Stab-Rabbit-coding/open-servo-core-secure/REFERENCES.md

# REFERENCES

Catalogue of every external standard, datasheet, specification and source this
repository relies on. Citations elsewhere in the codebase — in Rust doc
comments, Markdown, schematics and commit messages — refer to entries here by
**REF-ID**.

**Policy.** No reference, citation, standard, section number or constant is
ever fabricated. Where a value cannot be traced to a published document with a
validated URL, it is either omitted or explicitly marked *requires
verification*, and a `TODO.md` item is opened against it.

---

## Secure element

### REF-SE-001 — ECC204 CryptoAuthentication Summary Data Sheet

- **Designation:** Microchip DS40002436C (2023–2025)
- **Title:** *ECC204 CryptoAuthentication™ Summary Data Sheet*
- **URL:** <https://ww1.microchip.com/downloads/aemDocuments/documents/SCBU/ProductDocuments/DataSheets/ECC204-CryptoAuthentication-Summary-Data-Sheet-DS40002436.pdf>
- **Local copy:** `docs/ECC204-CryptoAuthentication-Summary-Data-Sheet-DS40002436.pdf`
- **Sections applied:**
  - *Features* (p. 1) — ECDSA P-256 **sign only**; SHA-256 and HMAC; internal
    TRNG; single ECC private key, one device certificate, one CA signer
    certificate, single symmetric secret key, 64-byte user memory; monotonic
    counter **max 10 000**; unique 72-bit serial; SWI at **100 kbps** and I²C
    at **400 kHz**; JIL "High" attack-potential resistance; FIPS 140-3
    compliance-mode option.
  - *Table 1 / Figure 1* (p. 2) — pin configuration; SWI vs I²C pin functions;
    3-lead contact, 8-pad UDFN, 8-lead SOIC packages.
  - *§1.2 Device Features* — EEPROM contents, interface options, parasitic
    power mode, counter attachment to key.
  - *§1.3 Cryptographic Operation* — private key generated internally, never
    exposed.
  - *§2.1 Cryptographic Standards* — SHA-256 (FIPS 180-4), HMAC (FIPS 198-1),
    ECDSA (ANSI X9.62-2005, FIPS 186-5).
  - *§2.2.2 Random Number Generator* — SP 800-90A/B/C certified TRNG.
  - *§2.2.3 Compliance Mode* — FIPS 140-3 enforcement bit.
  - *§3.1 Absolute Maximum Ratings* — ESD HBM **> 4 kV (I²C)**, **> 7 kV
    (SWI)**, CDM > 2 kV.
  - *§3.2.1* — DC parameters, all I/O interfaces: Theta-JA **91.5°C/W** for
    the 3-lead contact package (soldered-down); sleep current 130 nA typ.
  - *§3.2.2 / §3.2.3* — SWI DC parameters and parasitic-power mode.
  - *§4 / Table 4-1* — Trust&GO / TrustFLEX / TrustCUSTOM provisioning flows;
    ordering codes. **Note 3**: the TrustCUSTOM sample device
    `ECC204-TCSMU`/`ECC204-TCSMS` is stated equivalent to
    `ECC204-MAVDA-T`/`ECC204-SSVDA-T` — **I²C**, not SWI. This table does not
    show a 3-lead-contact or SWI (`CZ`) Trust Platform SKU; it is a
    "representative sample" (Note 1), not exhaustive. This is the open part of
    the `TODO.md` §7.1 blocker — whether a pre-provisioned (TrustFLEX/
    TrustCUSTOM) SWI part exists is still unconfirmed from this datasheet.
  - *§6.1 / Package Drawings — 8-Pad UDFN* (Q4B, Atmel legacy code YNZ,
    Microchip drawing C04-21355-Q4B Rev C): body 2.00×3.00 mm BSC, height
    0.50–0.60 mm, pitch (`e`) 0.50 mm BSC, exposed pad D2 1.40–1.60 mm,
    exposed pad E2 1.20–1.40 mm, terminal width (`b`) 0.18–0.30 mm, terminal
    length (`L`) 0.25–0.45 mm, **terminal-to-exposed-pad (`K`) 0.20 mm min**.
    Used, with the `K` clearance applied against the pulled-in peripheral
    pads rather than the nominal exposed-pad size, for
    `hardware/shared.pretty/ECC204_UDFN-8-1EP_L2.0-W3.0-P0.50-EP0.61x1.3mm.kicad_mod`
    — see that file's description field and `TODO.md` §7.8 for the exact
    derivation; verify against a real part/stencil before fab.
  - *§6.3 / Package Drawings — 3-Lead Contact* (Atmel legacy code RHB,
    Microchip drawing C04-21303 Rev A): body 6.50×2.50 mm BSC, height
    0.45–0.55 mm, pitch 2.00 mm BSC, terminal width (`b`) 1.60–1.80 mm,
    terminal length (`L`) 2.10–2.30 mm. **Superseded** — see "Removed /
    superseded citations" below; this package does not fit
    `osc-sg90-v006`'s routed copper anywhere.
  - *§7 / Product Identification System* — the **plain** (non-Trust-Platform)
    ordering-code grammar has an explicit interface column: package `RB`
    (3-lead contact) / `MA` (UDFN) / `SS` (SOIC) × I/O type `CZ` (SWI) /
    `DA` (I²C). `ECC204-MAVCZ-T` (8-pad UDFN, extended temp, SWI, tape &
    reel) is a **verbatim example** from this section, used as the schematic
    symbol name (`hardware/shared.kicad_sym`,
    `hardware/boards/osc-sg90-v006/osc-sg90-v006.kicad_sch` U7). This is a
    real, orderable **unprovisioned** device — it is not the fleet
    provisioning SKU, which remains open per `TODO.md` §7.1/§7.5.
- **Cited from:** `docs/security-architecture.md` (§0.1–0.5, §2, §3, §5, §6),
  `firmware/lib/drivers/src/se/ecc204.rs`,
  `firmware/lib/osc-security/src/se.rs`, `firmware/lib/osc-security/src/keys.rs`
- **Limitation (important):** this is the **summary** datasheet. It states on
  its cover that the complete document is available only under NDA. It
  contains **no command set, no execution times, no command-packet framing and
  no SWI token timing**. Those gaps are the reason for the compile gate in
  `se/ecc204.rs` (see `TODO.md` §7.4).

### REF-SE-002 — Microchip CryptoAuthLib

- **Title:** *CryptoAuthLib — Library for interacting with the CryptoAuthentication secure elements*
- **URL:** <https://github.com/MicrochipTech/cryptoauthlib>
- **Files applied:**
  - `lib/calib/calib_command.h` — command opcodes (`ATCA_READ` 0x02,
    `ATCA_MAC` 0x08, `ATCA_WRITE` 0x12, `ATCA_DELETE` 0x13, `ATCA_NONCE` 0x16,
    `ATCA_LOCK` 0x17, `ATCA_COUNTER` 0x24, `ATCA_INFO` 0x30, `ATCA_GENKEY`
    0x40, `ATCA_SIGN` 0x41, `ATCA_SHA` 0x47, `ATCA_SELFTEST` 0x77);
    ECC204-specific SHA modes (`SHA_MODE_ECC204_HMAC_START` 0x03,
    `SHA_MODE_ECC204_HMAC_END` 0x02); `COUNTER_MAX_VALUE_CA2` = 10000;
    `ATCA_CA2_CONFIG_SIZE` = 64; `ATCA_CA2_CONFIG_SLOT_SIZE` = 16.
  - `lib/calib/calib_execution.c` — `device_execution_time_ecc204` table:
    `COUNTER` 20 ms, `DELETE` 200 ms, `GENKEY` 500 ms, `INFO` 20 ms, `LOCK`
    80 ms, `NONCE` 20 ms, `READ` 40 ms, `SELFTEST` 600 ms, `SHA` 80 ms,
    `SIGN` 500 ms, `WRITE` 80 ms.
- **Cited from:** `firmware/lib/drivers/src/se/ecc204.rs`,
  `docs/security-architecture.md` §0.1
- **Note:** used as a **documentary source for interface constants only**. No
  CryptoAuthLib code is copied into this repository; the drivers here are
  independent Rust implementations. CryptoAuthLib is distributed under
  Microchip's own licence — consult it before vendoring any of its code.
- **Cross-check:** the 10 000 counter ceiling appears independently in
  REF-SE-001 §Features and in `COUNTER_MAX_VALUE_CA2`, which is why it is
  treated as reliable.

### REF-SE-003 — CryptoAuthLib SWI-over-UART HAL

- **Title:** *cryptoauthlib — `lib/hal/hal_swi_uart.c`*
- **URL:** <https://github.com/MicrochipTech/cryptoauthlib/blob/main/lib/hal/hal_swi_uart.c>
- **Applied:** the SWI-over-UART encoding — **230 400 baud** for data
  (115 200 during the wake sequence), **one UART character per SWI data bit**
  (`0x7F` = logic 1, `0x7D` = logic 0), **LSB first**, receive tolerance
  `(c ^ 0x7F) < 2`.
- **Cited from:** `firmware/lib/drivers/src/se/swi.rs`,
  `docs/security-architecture.md` §0.1, §0.3
- **Note:** independent Rust implementation of the documented encoding; no code
  copied.

### REF-SE-004 — Security Exchange Process for TrustFLEX and TrustCUSTOM Provisioning

- **Designation:** Microchip DS50004144
- **Title:** *Security Exchange Process for TrustFLEX and TrustCUSTOM Provisioning*
- **Local copy:** `docs/Security-Exchange-Process-for-TrustFLEX-and-TrustCUSTOM-Provisioning-DS50004144.pdf`
- **Applied:** provisioning flow and Secure Exchange Package handling.
- **Cited from:** `docs/security-architecture.md` §5.1
- **Status:** *requires verification* — specific section numbers have not yet
  been extracted and applied. `TODO.md` §7.5.

### REF-SE-005 — Trust Platform Manifest File Full Format

- **Designation:** Microchip DS60001759
- **Local copy:** `docs/Trust-Platform-Manifest-File-Full-Format-DS60001759.pdf`
- **Status:** *requires verification* — held for the provisioning workflow; not
  yet cited from code or design docs.

### REF-SE-006 — Infineon OPTIGA Trust M datasheet

- **Local copy:** `docs/infineon-optiga-trust-m-datasheet-en.pdf`
- **Status:** held as a **considered alternative** to the ECC204. Not selected;
  not cited from code. Retained for the trade record.

### REF-SE-007 — 3-Lead Contact Package Usage

- **Designation:** Microchip DS00004041
- **Local copy:** `docs/3-Lead-Contact-Package-Usage-DS00004041.pdf`
- **Applied:** mechanical usage of the 3-lead contact package considered for
  the SG90 board (§0.3.1).
- **Status:** *requires verification* — section numbers not yet extracted.

---

## Cryptographic algorithms

### REF-CRYPTO-001 — SipHash

- **Title:** Jean-Philippe Aumasson and Daniel J. Bernstein, *"SipHash: a fast
  short-input PRF"*, INDOCRYPT 2012, LNCS 7668, pp. 489–508.
- **DOI:** <https://doi.org/10.1007/978-3-642-34931-7_28>
- **Author's page:** <https://www.aumasson.jp/siphash/siphash.pdf>
- **Applied:** the SipHash round function, key schedule and finalisation.
  HalfSipHash is the 32-bit-word variant.
- **Cited from:** `firmware/lib/osc-security/src/mac.rs`,
  `docs/security-architecture.md` §2.4

### REF-CRYPTO-002 — SipHash reference implementation

- **URL:** <https://github.com/veorq/SipHash>
- **Files applied:** `halfsiphash.c` (round function, initial state
  `v2 = 0x6c796765` / `v3 = 0x74656462`, key mixing, `cROUNDS` = 2 /
  `dROUNDS` = 4, tail construction, `v2 ^= 0xff` finalisation for 32-bit
  output, `b = v1 ^ v3`); `vectors.h` (`vectors_hsip32`); `test.c` (vector
  convention: `k[i] = i`, `in[i] = i`, message length = vector index).
- **Cited from:** `firmware/lib/osc-security/src/mac.rs` (test vectors)
- **Licence:** CC0 / public domain dedication. The implementation in this
  repository is independent Rust written against the published algorithm; the
  **test vectors** are taken directly, which is their purpose.

---

## Cryptographic standards

### REF-STD-001 — FIPS 180-4, Secure Hash Standard

- **URL:** <https://nvlpubs.nist.gov/nistpubs/FIPS/NIST.FIPS.180-4.pdf>
- **Applied:** SHA-256, as implemented by the ECC204 (REF-SE-001 §2.1.1).

### REF-STD-002 — FIPS 186-5, Digital Signature Standard

- **URL:** <https://nvlpubs.nist.gov/nistpubs/FIPS/NIST.FIPS.186-5.pdf>
- **Applied:** ECDSA over NIST P-256, as implemented by the ECC204
  (REF-SE-001 §2.1.3). Note REF-SE-001 §Features cites FIPS 186-**4** while
  §2.1.3 cites FIPS 186-**5**; the datasheet is internally inconsistent on this
  point. Both are recorded; the design does not depend on the difference.

### REF-STD-003 — FIPS 198-1, The Keyed-Hash Message Authentication Code (HMAC)

- **URL:** <https://csrc.nist.gov/publications/fips/fips198-1/FIPS-198-1_final.pdf>
- **Applied:** HMAC-SHA-256 as the session KDF, executed inside the ECC204
  (REF-SE-001 §2.1.2).
- **Cited from:** `docs/security-architecture.md` §3, §6;
  `firmware/lib/osc-security/src/keys.rs`

### REF-STD-004 — NIST SP 800-90A/B/C, Random Bit Generation

- **URLs:**
  - <https://nvlpubs.nist.gov/nistpubs/SpecialPublications/NIST.SP.800-90Ar1.pdf>
  - <https://nvlpubs.nist.gov/nistpubs/SpecialPublications/NIST.SP.800-90B.pdf>
  - <https://nvlpubs.nist.gov/nistpubs/SpecialPublications/NIST.SP.800-90C.2pd.pdf>
- **Applied:** the ECC204's TRNG construction and certification
  (REF-SE-001 §2.2.2).

### REF-STD-005 — ANSI X9.62-2005

- **Title:** *Public Key Cryptography for the Financial Services Industry: The Elliptic Curve Digital Signature Algorithm (ECDSA)*
- **URL:** <https://www.ansi.org/>
- **Applied:** ECDSA, as cited by REF-SE-001 §2.1.3.
- **Status:** paywalled; cited because the datasheet cites it. The design
  depends on FIPS 186-5 (REF-STD-002), which is freely available.

### REF-STD-006 — FIPS 140-3

- **URL:** <https://nvlpubs.nist.gov/nistpubs/FIPS/NIST.FIPS.140-3.pdf>
- **Applied:** the ECC204's compliance-mode configuration bit
  (REF-SE-001 §2.2.3).
- **Status:** *requires verification* — the specific aspects the ECC204's
  compliance bit enforces are not enumerated in the summary datasheet.

---

## Microcontroller

### REF-MCU-001 — CH32V006 datasheet and reference manual

- **Vendor:** WCH (Nanjing Qinheng Microelectronics)
- **URL:** <https://www.wch-ic.com/products/CH32V006.html>
- **Applied:** RV32EC core, 48 MHz, 62 KB flash / 8 KB SRAM, USART and pin
  alternate-function mapping, factory ESIG unique ID (RM ch. 19), HSITRIM.
- **Cited from:** `docs/osc-native-protocol.md` §9.2, §10;
  `docs/security-architecture.md` §0.3, §0.4
- **Status:** *requires verification* — the USART instance and remap index for
  `PD5`/`PD6` on the CH32V006F8U6 shall be confirmed against
  `ch32_metapac::METADATA` before the SWI pin assignment is frozen
  (`TODO.md` §7.2).

---

## Fabrication and board design

### REF-FAB-001 — PCBWay manufacturing capability and design rules

- **Designation:** PCBWay published capability tables and Help Center design
  rulings (accessed 2026-08-29)
- **URLs:**
  - <https://www.pcbway.com/capabilities.html>
  - <https://www.pcbway.com/helpcenter/board_outline_issues/The_distance_between_the_trace_and_board_outline_is_less_than_0_20mm.html>
  - <https://www.pcbway.com/helpcenter/Engineering_Questions/the_spacing_requirement_from_hole_to_the_edge_of_board.html>
- **Why this is the governing source:** PCBWay fabricates and assembles this
  project's boards (`README.md` §Sponsorship). Board-edge spacing on a 3.3–8.4 V
  design is set by the fabricator's routing tolerance, not by electrical
  clearance — see REF-STD-007 for why the electrical requirement is not
  binding here.
- **Sections applied:**
  - *Capabilities — minimum trace / spacing:* 0.1 mm (4 mil) each. Consistent
    with the 0.10 mm `Track width minimum` and `Copper clearance` rules in
    `hardware/boards/osc-sg90-v006/osc-sg90-v006.kicad_dru`.
  - *Capabilities — minimum via drill / annular ring:* 0.15 mm drill,
    0.15 mm annular ring. The board is more conservative: 0.30 mm drill,
    0.125 mm annular ring.
  - *Capabilities — outline (CNC routing):* 0.25 mm copper-to-outline for the
    normal process; ±0.2 mm outline tolerance for CNC routing, ±0.5 mm for
    V-scoring.
  - *Help Center — "The distance between the trace and board outline is less
    than 0.20mm":* **"The distance between the trace and board outline should
    be 0.20mm for us to proceed."** This is the hard DFM gate. Applied as the
    floor under the `Copper to board edge` rule, which is set to **0.30 mm**
    — 1.5× the gate and above the 0.25 mm normal-process figure.
  - *Help Center — "the spacing requirement from hole to the edge of board":*
    **"The distance from hole (no matter PTH hole or unplated hole) to outline
    of board should be ≧ 0.5mm."** Note also **"For panel made via v-scoring
    line, 1.0mm spacing from hole to edge is required."** The 0.5 mm figure is
    stricter than the copper rule and is what actually limits how close a via
    may sit to the edge: for this board's 0.55/0.30 mm via it puts the via
    centre 0.65 mm inboard. Enforced as a `physical_hole_clearance` rule
    conditioned on `B.Layer == 'Edge.Cuts'` in the board's `.kicad_dru`, and
    cross-checked independently by `hardware/tools/check_hole_to_edge.py`.
    Note also **"For panel made via v-scoring line, 1.0mm spacing from hole to
    edge is required"** — the 0.50 mm figure assumes CNC routing.
- **Cited from:** `hardware/boards/osc-sg90-v006/osc-sg90-v006.kicad_dru`
  (via `hardware/boards/osc-sg90-v006/README2.md`, since a `.kicad_dru` cannot
  hold comments — see `AGENTS.md` §Coding standards);
  `hardware/tools/check_hole_to_edge.py`
- **Status:** vendor capability document, not a consensus standard. It governs
  because it is the accepting fabricator's stated limit; if the board is moved
  to another fab, this entry shall be re-verified against that fab's tables.

### REF-STD-007 — IPC-2221B, Generic Standard on Printed Board Design

- **Designation:** IPC-2221B (2012)
- **Title:** *Generic Standard on Printed Board Design*
- **URL:** <https://shop.ipc.org/ipc-2221/ipc-2221-standard-only/Revision-b/english>
- **Sections applied:**
  - *§6.3 / Table 6-1, Electrical Conductor Spacing* — minimum spacing as a
    function of peak working voltage, by conductor location and coating, for
    altitudes below 3050 m (10 007 ft). This board's maximum working voltage is
    **8.4 V** (2S LiPo on `VIN`, `hardware/boards/osc-sg90-v006/README.md`),
    which falls in the lowest (0–15 V) band. The board is uncoated, so the
    external-uncoated column governs at **0.10 mm**. The board's global
    `Copper clearance` rule is already 0.10 mm and every netclass is at or
    above it (0.127 mm signal, 0.200 mm VSYS/MOTOR), so **the electrical
    requirement is satisfied with margin and is not the binding constraint on
    board-edge spacing** — REF-FAB-001 is. Recorded here so the reasoning is
    auditable rather than assumed.
- **Cited from:** `hardware/boards/osc-sg90-v006/osc-sg90-v006.kicad_dru`
  (via `hardware/boards/osc-sg90-v006/README2.md`)
- **Status:** *requires verification* — the standard is paywalled and has not
  been read directly. The Table 6-1 values quoted above were taken from
  secondary summaries of the table, not from the issued document. This does not
  affect the design: the applied clearances exceed the quoted values by 1.27×
  to 2×, and the governing constraint is REF-FAB-001 in any case. Superseded by
  **IPC-2221C** (December 2023), which has not been checked for changes to the
  spacing table or its numbering.

---

## Documentation and technical-writing standards

### REF-MIL-001 — CNAF M-3710.7, §1.5 (Warnings, Cautions, and Notes) and §1.6 (Wording)

Department of the Navy, Commander, Naval Air Forces, *NATOPS General Flight
and Operating Instructions Manual*, CNAF M-3710.7 (COMNAVAIRFOR M-3710.7),
Original, 2 May 2016. Source: NATEC NATOPS library,
<https://www.mynatec.navair.navy.mil/> (access-restricted); verified against
pages 1–52 of the issued manual (front matter, Chapter 1, Glossary, List of
Abbreviations/Acronyms), held locally at `docs/cnaf-3710.7_1-52.pdf` in the
`SecureControllers` repository.

Applied: §1.5 "Warnings, Cautions, and Notes" (p. 1-5) for callout-severity
definitions; §1.6 "Wording" (p. 1-5) for shall/should/may–need not/will
requirement-verb usage. This repository does not claim NATOPS compliance as
a whole — only the §1.5/§1.6 documentation-style conventions are adopted.
The paired active-vs-passive-voice guidance in `AGENTS.md` is a project
addition, not sourced from this document.

Cited in: `AGENTS.md` "Warnings, cautions, notes, and wording".

---

## Internal specifications

These are this repository's own normative documents, listed so that code
citations resolve consistently.

| REF-ID | Document |
| --- | --- |
| REF-OSC-001 | `docs/osc-native-protocol.md` — the wire protocol |
| REF-OSC-002 | `docs/osc-servo-transport.md` — the servo-side transport |
| REF-OSC-003 | `docs/control-theory.md` — the control cascade |
| REF-OSC-004 | `docs/driver-pattern.md` — the layering |
| REF-OSC-005 | `docs/security-architecture.md` — the security architecture |
| REF-OSC-006 | `docs/SecurityElement.md` — the originating design note |

---

## Removed / superseded citations

| Citation | Status | Reason |
| --- | --- | --- |
| "SWI effective throughput 28.8 kbit/s (230400 / 8)" | **Superseded** | Ignored UART start/stop bits. Each SWI data bit costs a whole 10-bit UART character, so a data byte is 80 bit-times: **23.0 kbit/s, ~347 µs/byte**. Corrected in `docs/security-architecture.md` §0.1 and pinned by `swi::transfer_time_us`. |
| "ECC204 HMAC round trip ≈ 100 ms" | **Superseded** | Assumed one command. An ECC204 HMAC is a **two-command** `SHA` sequence (`HMAC_START` + `HMAC_END`, REF-SE-002), so ≈ **208 ms**. Corrected in §0.1, §3. |
| ECC204 SWI on pin `PC1` (`main.rs.new` draft) | **Removed** | `PC1` is the bus receive path on the rev-B and `osc-sg90-v006` configurations and the Qwiic I²C SDA on `osc-dev-v006` Rev 2A. Never free. See §0.3. |
| `cortex_m::asm::nop()` in the `osc_security.rs` draft | **Removed** | ARM intrinsic on a RISC-V (QingKe RV32EC) target; could not compile. See §0.4. |
| Infineon OPTIGA Trust M as the selected SE | **Superseded** | ECC204 selected. REF-SE-006 retained for the trade record. |
| ECC204 3-Lead Contact package (`ECC204-RBVCZ-T`, footprint `ECC204_Contact-3_L6.5-W2.5-P2.00`) | **Superseded** | Confirmed via full computational search of `osc-sg90-v006`'s routed copper (both layers, every position, real pad/track/via/zone geometry) that this 6.5×2.5 mm package has **zero** clear placement on this board. Switched to the same real part's 8-Pad UDFN (`ECC204-MAVCZ-T`), which does fit. [REF-SE-001] §6.1 replaces §6.3 as the applicable package-drawing citation. Symbol/footprint files removed; see `TODO.md` §7.8. |
