Stab-Rabbit-coding/open-servo-core-secure/hardware/boards/osc-sg90-v006/_restore_backup_2026-08-31T15-10-42-913/osc-sg90-v006.kicad_pcb

## KiCad design hardware/boards/osc-sg90-v006/_restore_backup_2026-08-31T15-10-42-913/osc-sg90-v006.kicad_pcb (2026-09-13)

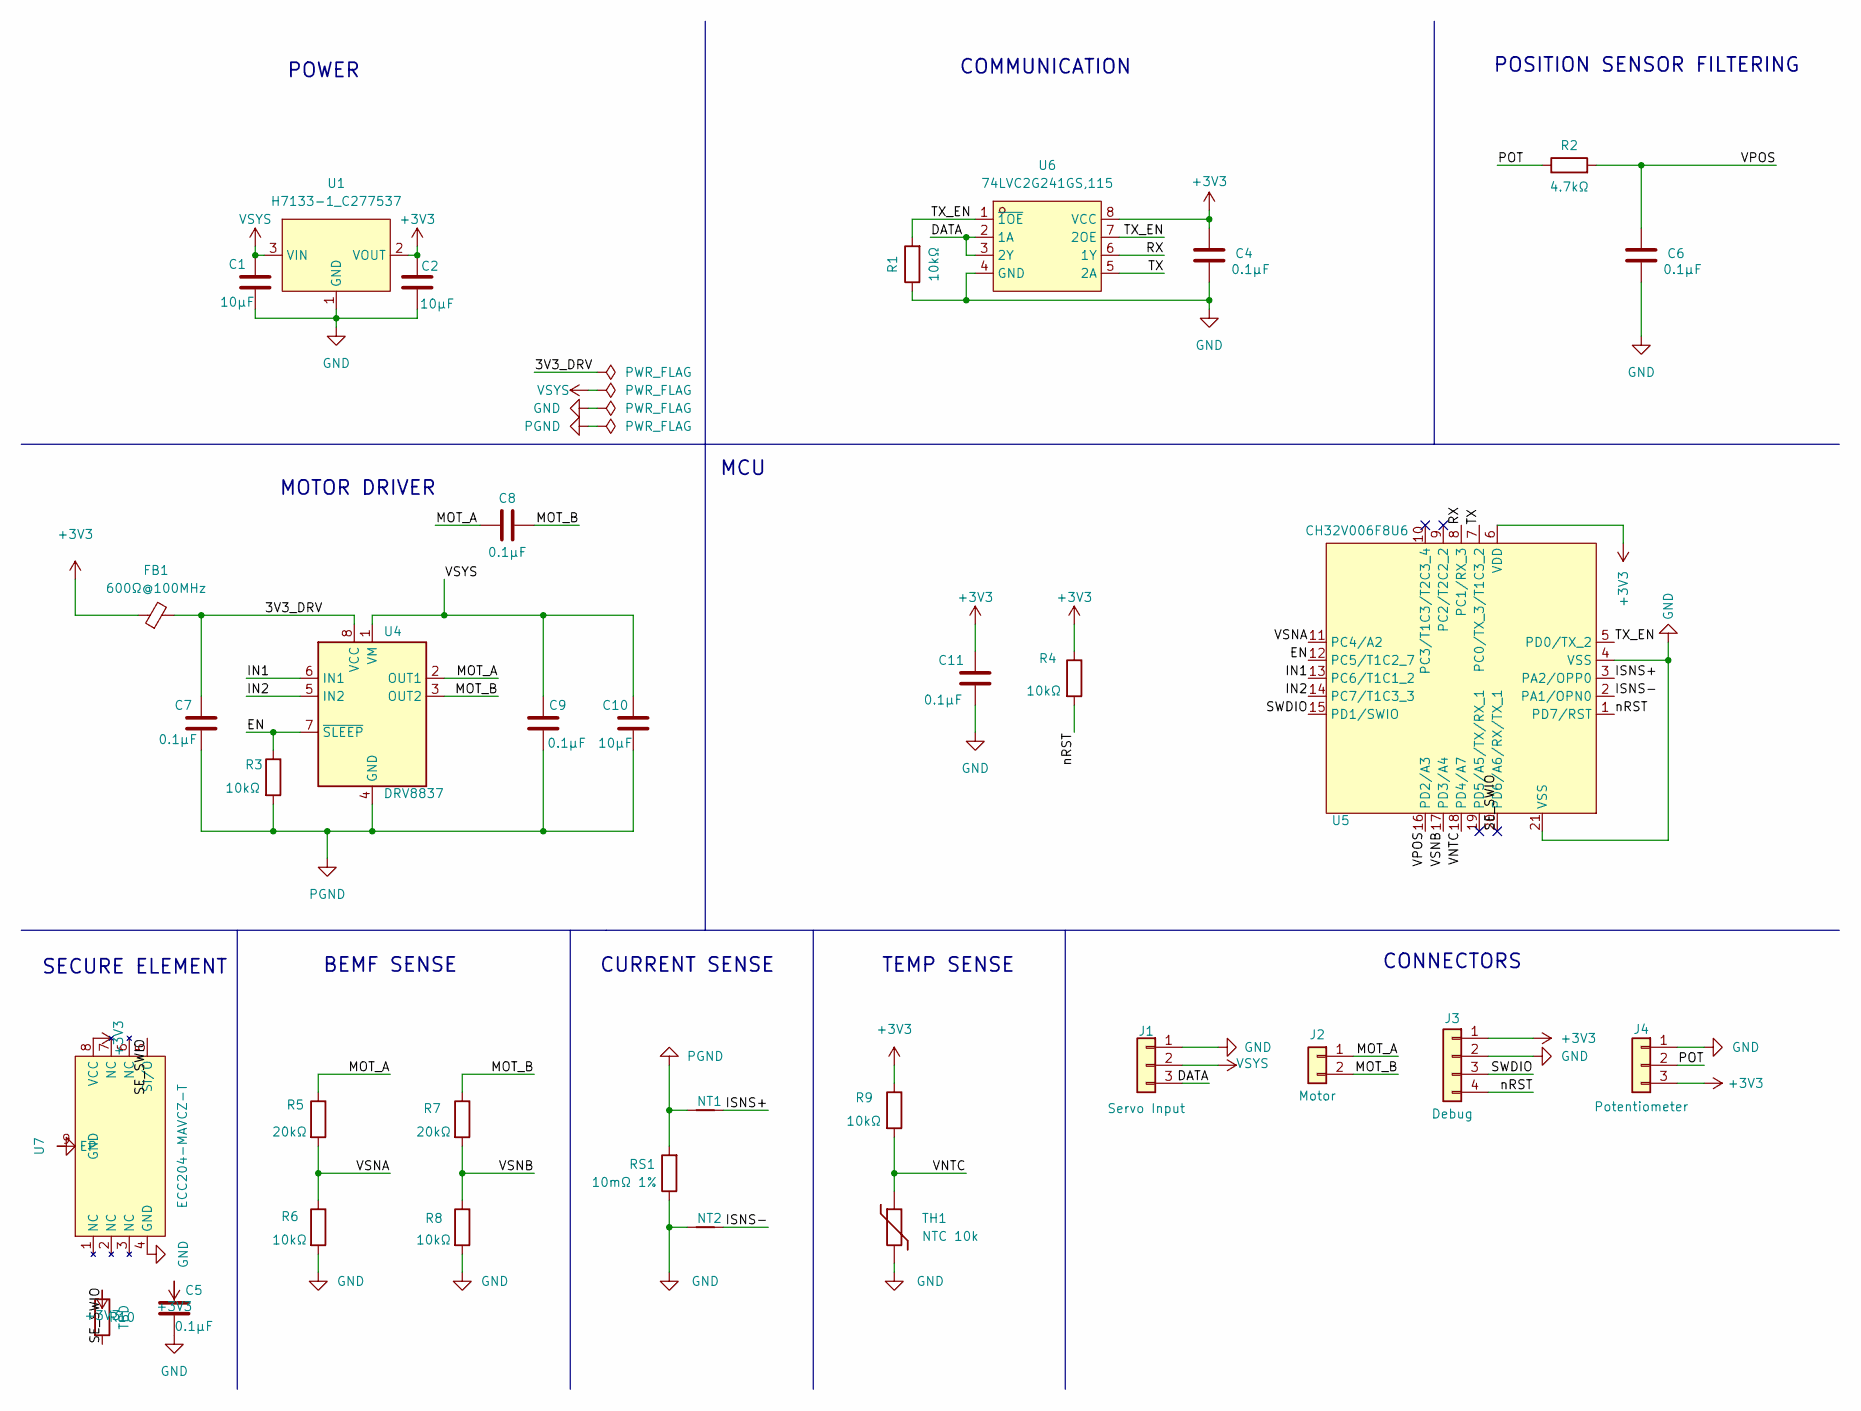
[picture p1: schematic osc-sg90-v006.kicad_sch, ${PROJECT} / ${BOARD}]

Parts:
C1, C2, C10: 10µF; C_0603_1608Metric; LCSC C96446
C4, C6, C7, C8, C9, C11: 0.1µF; C_0402_1005Metric; LCSC C1525
C5: 0.1µF; C_0402_1005Metric
FB1: 600Ω@100MHz; L_0402_1005Metric; LCSC C76884
J1: Servo Input; Servo_Output_Pads
J2: Motor; Motor_Wire_Pads
J3: Debug; Debug_Pads_1x4_P1.27mm
J4: Potentiometer; Pot_Wire_Pads
NT1, NT2: NetTie_2; NetTie-2_SMD_0.127mm
R1, R3, R4, R6, R8, R9: 10kΩ; R_0402_1005Metric; LCSC C25744
R2: 4.7kΩ; R_0402_1005Metric; LCSC C25900
R5, R7: 20kΩ; R_0402_1005Metric; LCSC C25765
R10: TBD; R_0402_1005Metric
RS1: 10mΩ 1%; R_0805_2012Metric; LCSC C163089
TH1: NTC 10k; R_0402_1005Metric; LCSC C77131
U1: H7133-1_C277537; SOT-23-3_L2.9-W1.3-P1.90-LS2.4-BR; LCSC Part C277537
U4: DRV8837; Texas_DSG0008A_WSON-8-1EP_2x2mm_P0.5mm_EP0.9x1.6mm; LCSC C39159
U5: CH32V006F8U6; UQFN-20_L3.0-W3.0-P0.40-BL-EP1.7; LCSC C42431288
U6: 74LVC2G241GS,115; XSON-8_L1.4-W1.0-P0.35-S0.55-BL; LCSC C548628
U7: ECC204-MAVCZ-T; ECC204_UDFN-8-1EP_L2.0-W3.0-P0.50-EP0.61x1.3mm

Connections:
+3V3: C2.1, C4.1, C5.1, C11.1, FB1.1, J3.1, J4.3, R4.1, R9.1, R10.1, U1.2 (VOUT), U5.6 (VDD), U6.8 (VCC), U7.8 (VCC)
/3V3_DRV: C7.1, FB1.2, U4.8 (VCC)
/DATA: J1.3, U6.2 (1A), U6.3 (2Y)
/EN: R3.1, U4.7 (~SLEEP), U5.12 (PC5/T1C2_7)
/IN1: U4.6 (IN1), U5.13 (PC6/T1C1_2)
/IN2: U4.5 (IN2), U5.14 (PC7/T1C3_3)
/ISNS+: NT1.1, U5.3 (PA2/OPP0)
/ISNS-: NT2.1, U5.2 (PA1/OPN0)
/MOT_A: C8.1, J2.1, R5.1, U4.2 (OUT1)
/MOT_B: C8.2, J2.2, R7.1, U4.3 (OUT2)
/POT: J4.2, R2.1
/RX: U5.8 (PC1/RX_3), U6.6 (1Y)
/SE_SWIO: R10.2, U5.20 (PD6/A6/RX/TX_1), U7.5 (SI/O)
/SWDIO: J3.3, U5.15 (PD1/SWIO)
/TX: U5.7 (PC0/TX_3/T1C3_2), U6.5 (2A)
/TX_EN: R1.2, U5.5 (PD0/TX_2), U6.1 (~1OE), U6.7 (2OE)
/VNTC: R9.2, TH1.1, U5.18 (PD4/A7)
/VPOS: C6.1, R2.2, U5.16 (PD2/A3)
/VSNA: R5.2, R6.1, U5.11 (PC4/A2)
/VSNB: R7.2, R8.1, U5.17 (PD3/A4)
/nRST: J3.4, R4.2, U5.1 (PD7/RST)
GND: C1.2, C2.2, C4.2, C5.2, C6.2, C11.2, J1.1, J3.2, J4.1, NT2.2, R1.1, R6.2, R8.2, RS1.1, TH1.2, U1.1 (GND), U5.4 (VSS), U5.21 (VSS), U6.4 (GND), U7.4 (GND), U7.9 (EP)
PGND: C7.2, C9.2, C10.2, NT1.2, R3.2, RS1.2, U4.4 (GND), U4.9 (GND)
VSYS: C1.1, C9.1, C10.1, J1.2, U1.3 (VIN), U4.1 (VM)

Notes on the sheet:
SECURE ELEMENT
POWER
MOTOR DRIVER
BEMF SENSE
CONNECTORS
TEMP SENSE
CURRENT SENSE
COMMUNICATION
MCU
POSITION SENSOR FILTERING

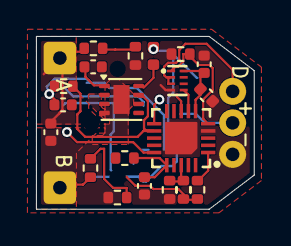
[picture p2: board osc-sg90-v006.kicad_pcb from above]

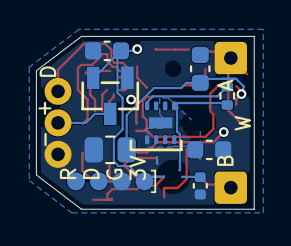
[picture p3: board osc-sg90-v006.kicad_pcb from below]

Board: 4 copper layers, 12.1 x 9.6 mm, 34 parts (11 on the bottom side), 24 nets.
