Stab-Rabbit-coding/open-servo-core-secure/(commit log)

2026-08-25 cleaned up a lot of stuff
    [osc-sg90-v006.kicad_pcb, osc-sg90-v006.kicad_sch, sg90-stock-reference.kicad_pcb]
2026-08-31 chore(sg90): capture KiCad 10 schematic re-serialisation
    Positional/serialisation churn written by KiCad 10.0.3 during the manual
    placement session, already present in the working tree before the re-route
    work began. Verified to be non-semantic: the set of references, values,
    lib_ids and labels, and the wire count, are all identical to HEAD.
    Committed on its own so the re-route commits that follow contain only
    deliberate design changes.
    [osc-sg90-v006.kicad_sch]
2026-08-31 feat(sg90): derive board-edge clearance from standards; add hole-to-edge check
    The previous 0.40 mm copper-to-edge value was unsourced. It is now 0.30 mm,
    derived:
    - The electrical requirement is not binding. This board's maximum working
    voltage is 8.4 V (2S LiPo on VIN, per the board README). IPC-2221B
    Table 6-1, external conductors uncoated, below 3050 m, puts the 0-15 V
    band at 0.10 mm [REF-STD-007] - already met by the global 0.10 mm
    copper-clearance rule and exceeded by every netclass.
    - The fabricator's routing tolerance is binding. PCBWay, who build this
    project's boards, reject artwork below 0.20 mm copper-to-outline and quote
    0.25 mm for the normal CNC-routing process [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
2026-08-31 feat(sg90): re-route the board after the manual placement pass
    Re-routed with FreeRouting 2.2.4 against a .dsn exported from KiCad 10.0.3
    with all tracks cleared and the boundary inset 0.20 mm - Specctra has no
    per-item board-edge constraint, so the inset plus the router's own class
    clearance is the only lever available.
    Result, measured with kicad-cli 10.0.3 (--refill-zones):
    89 track segments, 2 vias
    unconnected items 57 -> 33
    DRC errors 9 -> 9
    DRC warnings 7 -> 7
    Every one of the 9 remaining errors is a placement defect that predates the
    route (TODO.md §10.3); the route closed 24 connections and introduced no
    violations of its own.
    J4 is why it does not go fu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
    [osc-sg90-v006.kicad_pcb]
2026-08-31 docs(sg90): catalogue the fab/IPC sources, open WBS §10, add the handoff
    REFERENCES.md gains a "Fabrication and board design" section:
    - REF-FAB-001 - PCBWay capability tables and Help Center design rulings, the
    governing source for board-edge spacing because PCBWay fabricate this
    project's boards (README.md §Sponsorship). Records the 0.20 mm
    trace-to-outline gate, the 0.25 mm normal-process CNC figure, and the
    0.50 mm hole-to-outline requirement, each quoted verbatim with its URL.
    Flagged as a vendor capability document rather than a consensus standard,
    to be re-verified if the board moves fabricator.
    - REF-STD-007 - IPC-2221B §6.3 / Table 6-1, recorded to show that the
    el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
2026-09-01 fixing drc and routing
    [osc-sg90-v006.kicad_pcb, osc-sg90-v006.kicad_sch]
